spiderman0528/riscv-cpu/(commit log)

2026-10-31 Add 5-stage pipelined RV32I core, SoC, ISS and Verilator co-simulation testbench
2026-10-31 Add DE10-Lite board wrapper, firmware, open-source timing flow; move branch-target logic to ID (Fmax 33.7 -> 40.8 MHz on ECP5)
    Claude-Session: https://claude.ai/code/session_01LAiiRNiW67FBD4Wfz3yBqA
